vvvvvdal/turtlebot4-pequi/Estrutural/README.md

# Turtlebot4 - Parte Estrutural (Pequi Mecânico)

A equipe estrutural tem como objetivo implementar a placa Jetson Orion nano, da NVIDIA, no lugar da Raspberry PI 4, originalmente proposta para o robô Turtlebot4

## Modelo da placa

O modelo da nova placa foi obtido pelo respositório GrabCAD,  https://grabcad.com/library/nvidia-jetson-nano-4

Captura de tela 2026-05-21 111509

## Modelo do robô

O modelo do robô TurtleBot4 foi obtido pelo GitHub, https://github.com/turtlebot/turtlebot4-hardware/tree/master/TurtleBot%204

Captura de tela 2026-05-21 112447

## Desafios de instalação 

A superfície de fixação da plataforma iRobot Create 3 fornece um grid 12x12 com furos M3. Com base nisso, modelamos nossa primeira iteração

Captura de tela 2026-05-19 210758

Logo percebemos que o suporte ficaria muito distante da abertura posterior, o que dificutaria o manuseio dos cabos. Para resolver isso, mudamos a posição das orelhas de fixação.  

### Segunda versão 

Captura de tela 2026-05-21 140723

Captura de tela 2026-05-21 140939

Tendo em vista a baixa sujeição da peça a forças concentradas e o custo de produção com filamentos de engenharia, também decidimos remover material em excesso, mantendo a função 
primária de fixação

Captura de tela 2026-05-20 181712

### Nova versão 

Depois de decidirmos utilizar o módulo XL4016 para regulação da tensão, o suporte teve de ser redesenhado para receber esse novo componente 

Captura de tela 2026-05-22 151623
Captura de tela 2026-05-22 145253

Mudamos a posição das orelhas de fixação mais uma vez, e reorganizamos posição final do suporte na superfície de fixação 

Captura de tela 2026-05-22 141224
Captura de tela 2026-05-22 141442

## Propostas 

### Fixação

Para fixação dos componentes ao suporte, optamos por parafusos M2.5x0.45, combinados com insertos roscados de latão, que podem ser inseridos no plástico usando um ferro de solda

Captura de tela 2026-05-21 114533

### Boas práticas 

Utilizamos rasgos ao longo da base do suporte para possibilitar uma possível organização de cabos, como também auxiliar na circulação de ar

Captura de tela 2026-05-22 142819
 
 ## Fabricação 

Exportamos a peça em formato .STEP direto para o fatiador OrcaSlicer. Decidimos imprimir em ABS, para atender aos requisitos de resistências mecânica e térmica. 
Por via das dúvidas, escolhemos aumentar o número de paredes para garantir durabilidade e utilizamos o recurso Brim para prevenir o 'warp' da peça.  

### Segunda versão

Captura de tela 2026-05-21 142059

### Nova versão

Captura de tela 2026-05-22 151431
