vvvvvdal/turtlebot4-pequi/Estrutural/03. Suporte.STEP

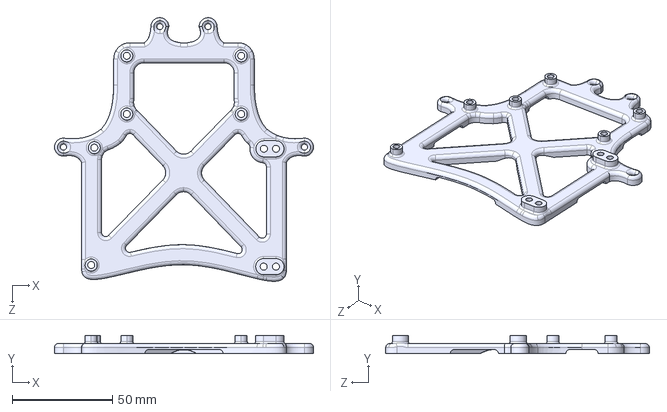
[picture p10: CAD file, 2026-05-22]
Estrutural/03. Suporte.STEP
129.0 x 9.00 x 131.3 mm
