vvvvvdal/turtlebot4-pequi/(list of files, cad)

Other CAD files:
Estrutural/03. Suporte.SLDPRT
