vvvvvdal/turtlebot4-pequi/(commit log)

2026-05-19 dockerfile para ros2 humble, tb4, slam, nav2, gazebo e yolo
2026-05-22 yolo com divisão de classes
2026-05-23 Reestrutura de containers
2026-05-23 adding Hardware to main
    [BOM_Board.csv, BOM_Board.xlsx]
